RoboticWorx/Custom-STM32s/README.md

# Custom-STM32s
How to build custom STM32-based PCBs!

Check out the full tutorial here for free: https://roboticworx.io/blogs/projects/build-custom-stm32s-from-scratch-tutorial

how stm32 cover flux fixed

Happy making!

Justin
