RoboticWorx/Custom-STM32s/MiniMCU-STM32H573RIT6-Designators.pdf

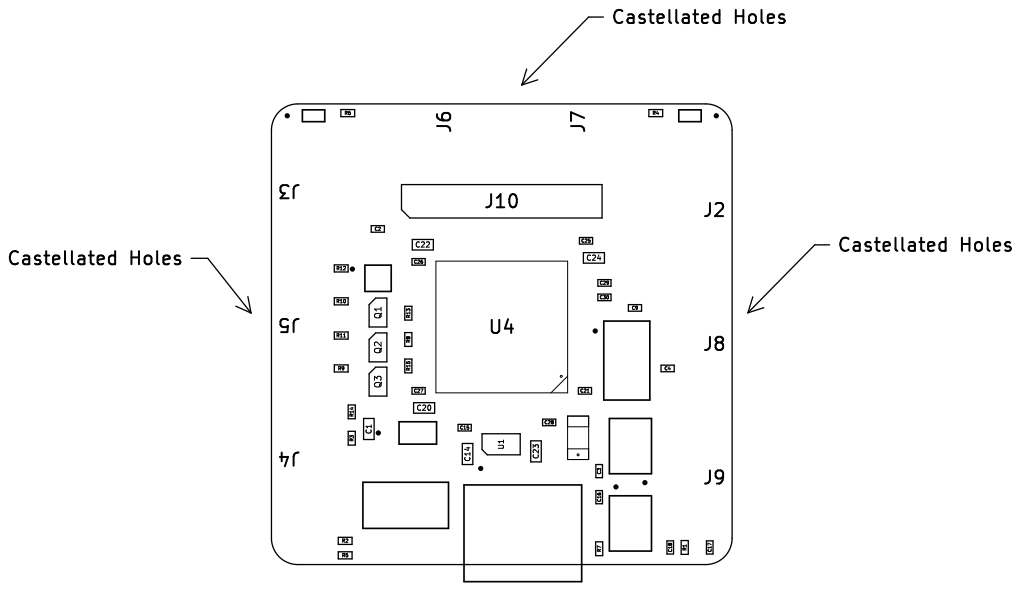
[picture p1: page 1]
