RoboticWorx/Custom-STM32s/MiniMCU-STM32H573RIT6-Schematic.pdf

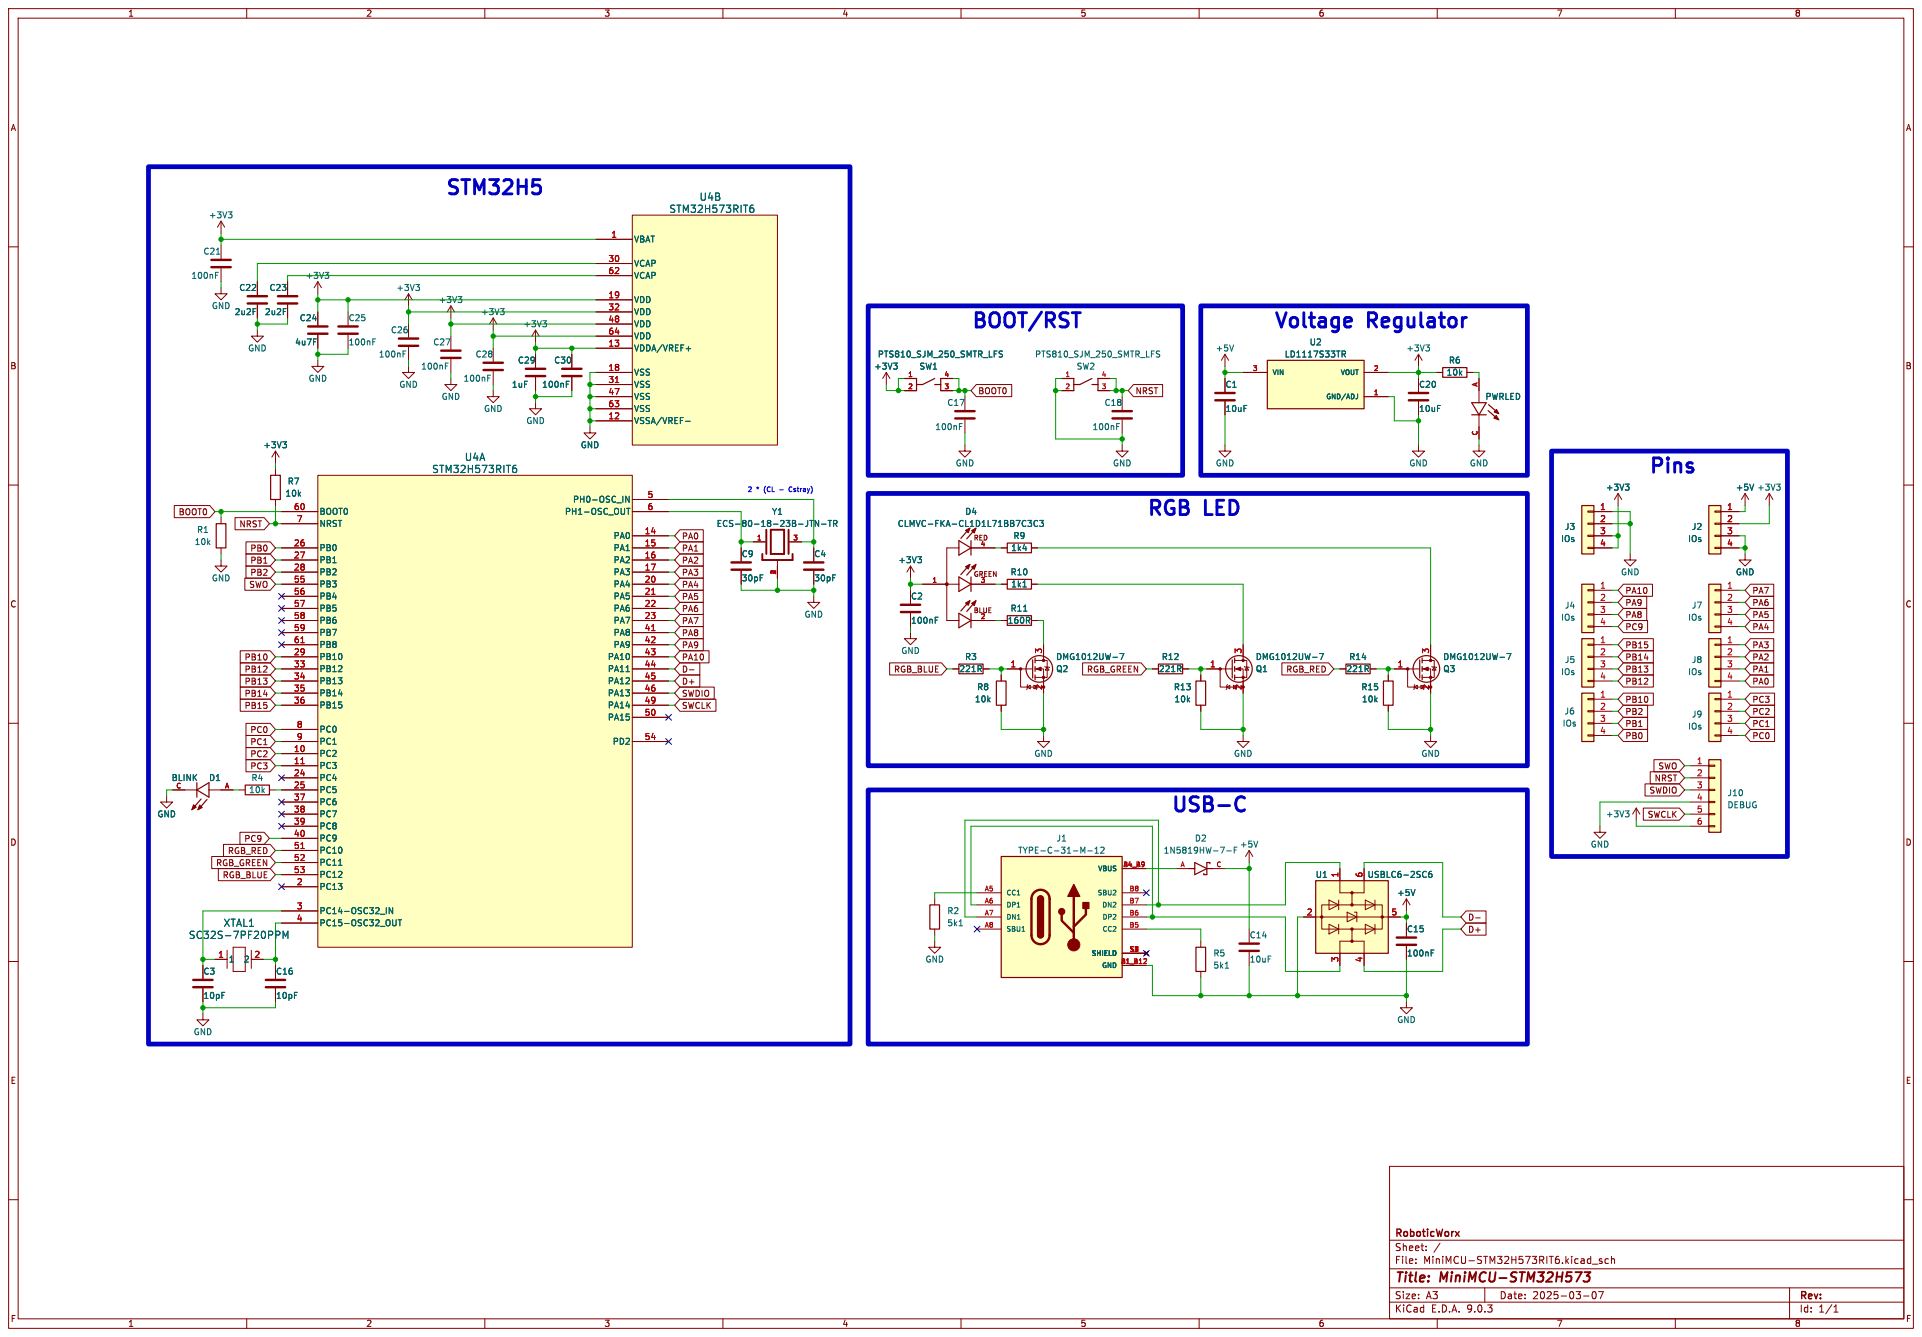
[picture p2: page 1]
