RoboticWorx/Custom-STM32s/Code/Core/Src/main.c

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
/* Includes ------------------------------------------------------------------*/
#include "main.h"

/* USER CODE BEGIN Includes */
#include <stdbool.h>
/* USER CODE END Includes */


I2C_HandleTypeDef hi2c2;
I2C_HandleTypeDef hi2c3;

I3C_HandleTypeDef hi3c1;

SPI_HandleTypeDef hspi1;
SPI_HandleTypeDef hspi2;

UART_HandleTypeDef huart4;
UART_HandleTypeDef huart1;
UART_HandleTypeDef huart2;

PCD_HandleTypeDef hpcd_USB_DRD_FS;

void SystemClock_Config(void);
static void MX_GPIO_Init(void);
static void MX_ICACHE_Init(void);
static void MX_I2C2_Init(void);
static void MX_I2C3_Init(void);
static void MX_I3C1_Init(void);
static void MX_SPI1_Init(void);
static void MX_SPI2_Init(void);
static void MX_UART4_Init(void);
static void MX_USART1_UART_Init(void);
static void MX_USART2_UART_Init(void);
static void MX_USB_PCD_Init(void);
/* USER CODE BEGIN 0 */

#define LED_ON GPIO_PIN_SET
#define LED_OFF GPIO_PIN_RESET

static bool blink_state = false;

static inline void rgb_set(uint8_t r, uint8_t g, uint8_t b)
{
  // Adjust GPIOC to whatever port your LED pins are on
  HAL_GPIO_WritePin(GPIOC, RGB_RED_Pin, r ? LED_ON : LED_OFF);
  HAL_GPIO_WritePin(GPIOC, RGB_GREEN_Pin, g ? LED_ON : LED_OFF);
  HAL_GPIO_WritePin(GPIOC, RGB_BLUE_Pin, b ? LED_ON : LED_OFF);
}

/* USER CODE END 0 */

/**
  * @brief  The application entry point.
  * @retval int
  */
int main(void)
{

  /* MCU Configuration--------------------------------------------------------*/

  /* Reset of all peripherals, Initializes the Flash interface and the Systick. */
  HAL_Init();

  /* Configure the system clock */
  SystemClock_Config();

  /* Initialize all configured peripherals */
  MX_GPIO_Init();
  MX_ICACHE_Init();
  MX_I2C2_Init();
  MX_I2C3_Init();
  MX_I3C1_Init();
  MX_SPI1_Init();
  MX_SPI2_Init();
  MX_UART4_Init();
  MX_USART1_UART_Init();
  MX_USART2_UART_Init();
  MX_USB_PCD_Init();
  /* Infinite loop */
  /* USER CODE BEGIN WHILE */
  while (1) {
    static const uint8_t seq[] = {
      0b001, // Red
      0b010, // Green
      0b100, // Blue
      0b011, // Yellow (red+green)
      0b101, // Magenta (red+blue)
      0b110, // Cyan (green+blue)
      0b111, // White (red+green+blue)
      0b000  // Off
    };
    static size_t i = 0;

    uint8_t c = seq[i];
    rgb_set((c & 0b001) != 0, (c & 0b010) != 0, (c & 0b100) != 0);

    HAL_Delay(100);
    HAL_GPIO_WritePin(GPIOC, BLINK_Pin, blink_state); // Blink LED
    blink_state = !blink_state; // Alternate blink on/off

    i = (i + 1) % (sizeof(seq)); // Increment RGB sequence with wrap
  }
  /* USER CODE END WHILE */

}

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
