RoboticWorx/Custom-STM32s/Code/MiniMCU-STM32H573RIT6.ioc

Mcu.UserName=STM32H573RITx
PA0.Signal=UART4_TX
PA1.Signal=UART4_RX
PA11.Signal=USB_DM
PA12.Signal=USB_DP
PA13(JTMS/SWDIO).Signal=DEBUG_JTMS-SWDIO
PA14(JTCK/SWCLK).Signal=DEBUG_JTCK-SWCLK
PA2.Signal=USART2_TX
PA3.Signal=USART2_RX
PA5.Signal=SPI1_SCK
PA6.Signal=SPI1_MISO
PA7.Signal=SPI1_MOSI
PA8.Signal=I2C3_SCL
PB10.Signal=I2C2_SCL
PB12.Signal=I2C2_SDA
PB13.Signal=SPI2_SCK
PB14.Signal=USART1_TX
PB15.Signal=USART1_RX
PB3(JTDO/TRACESWO).Signal=DEBUG_JTDO-SWO
PB6.Signal=I3C1_SCL
PB7.Signal=I3C1_SDA
PC1.Signal=SPI2_MOSI
PC10.GPIO_Label=RGB_RED
PC10.Signal=GPIO_Output
PC11.GPIO_Label=RGB_GREEN
PC11.Signal=GPIO_Output
PC12.GPIO_Label=RGB_BLUE
PC12.Signal=GPIO_Output
PC14-OSC32_IN(OSC32_IN).Signal=RCC_OSC32_IN
PC15-OSC32_OUT(OSC32_OUT).Signal=RCC_OSC32_OUT
PC2.Signal=SPI2_MISO
PC5.GPIO_Label=BLINK
PC5.Signal=GPIO_Output
PC9.Signal=I2C3_SDA
PH0-OSC_IN(PH0).Signal=RCC_OSC_IN
PH1-OSC_OUT(PH1).Signal=RCC_OSC_OUT
