RoboticWorx/Custom-STM32s/Code/Core/Inc/main.h

#define BLINK_Pin GPIO_PIN_5
#define BLINK_GPIO_Port GPIOC
#define RGB_RED_Pin GPIO_PIN_10
#define RGB_RED_GPIO_Port GPIOC
#define RGB_GREEN_Pin GPIO_PIN_11
#define RGB_GREEN_GPIO_Port GPIOC
#define RGB_BLUE_Pin GPIO_PIN_12
#define RGB_BLUE_GPIO_Port GPIOC
