RoboticWorx/Custom-STM32s/(notices)

Notices in the files:
Code/Core/Inc/main.h:
Copyright (c) 2025 STMicroelectronics.
All rights reserved.
This software is licensed under terms that can be found in the LICENSE file
